brainsmoke/mechpad/README.md

# mechanical keypad

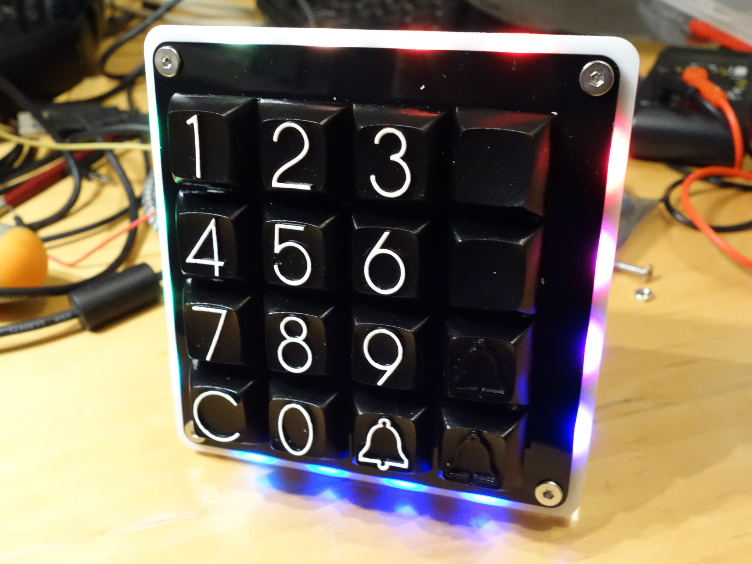
[picture p1: images/mechpad0.jpg]
|  |
|-|
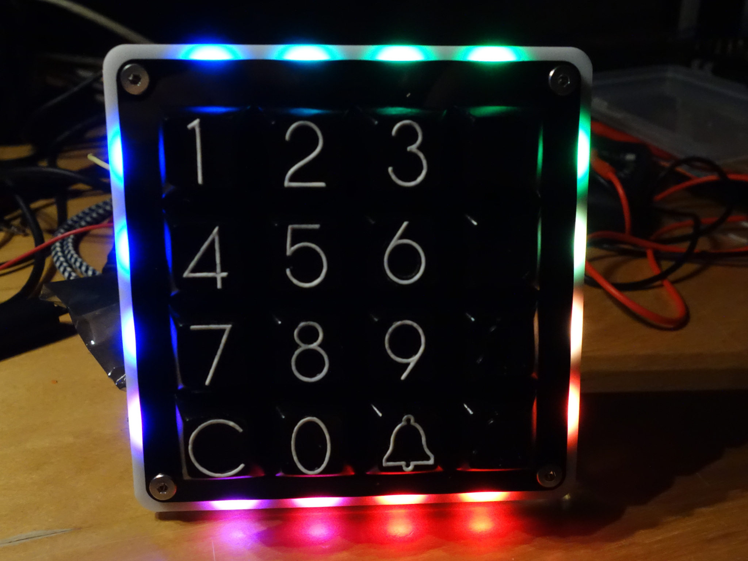
[picture p2: images/mechpad1.jpg]
|  |
