brainsmoke/mechpad/firmware/usbhid/README.md

# USB HID Keypad example

```
make -C ../libopencm3/ # if not done already
make
gdb-multiarch uartkeys.elf
set mem inaccessible-by-default off
target extended-remote /dev/ttyACM0
monitor swdp_scan
attach 1
load
run
```
