brainsmoke/mechpad/pcb/back.png

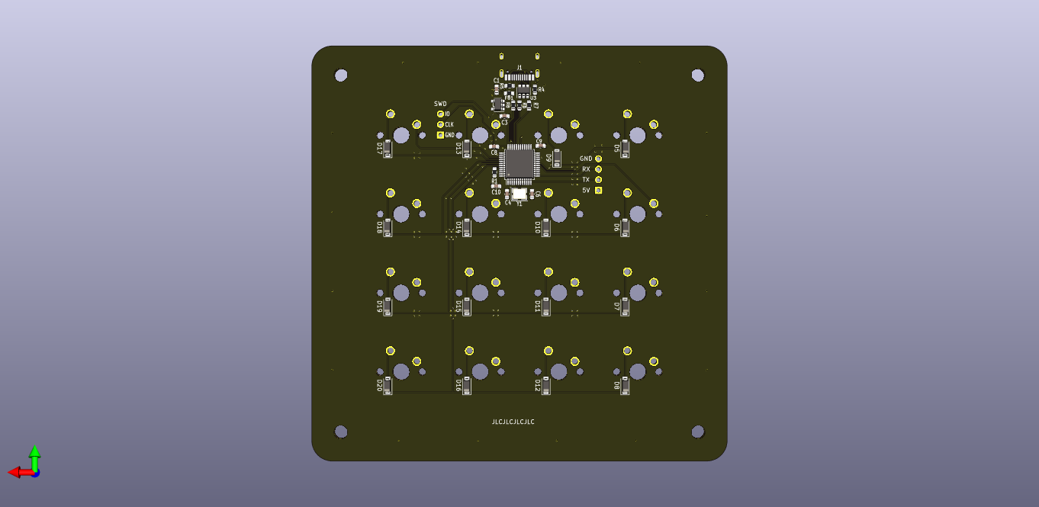
pcb/back.png
