brainsmoke/mechpad/pcb/pcb-bom.csv

Comment | Designator | Footprint | LCSC Part Number
100nF | C2 C5 C7 C11 C12 C13 C14 C15 C16 C17 C18 C19 C20 C21 C22 C23 | "0603" | "C14663"
SK6812SIDE-A-RVS | D1 D2 D3 D4 D21 D22 D23 D24 D25 D26 D27 D28 D29 D30 D31 D32 | SMD,2x4mm | C2890037
