brainsmoke/mechpad/keycaps/stl/7_fdm.stl

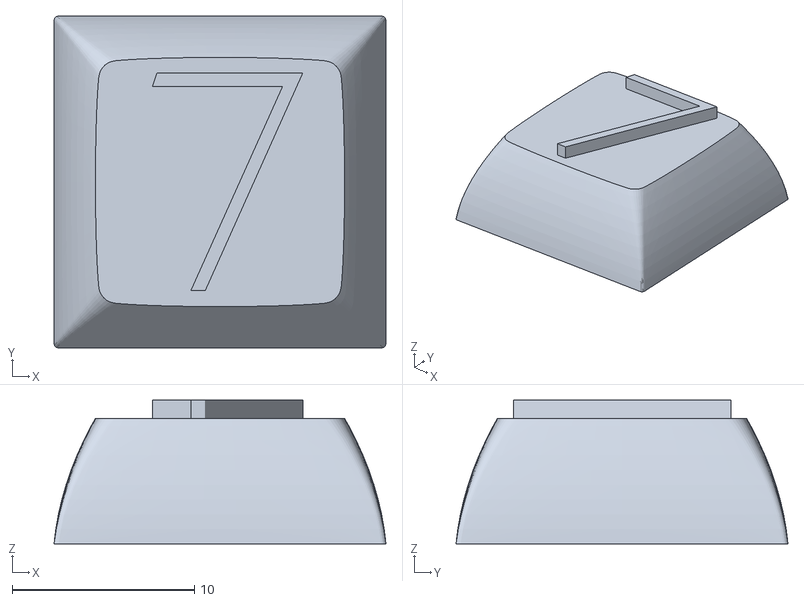
[picture p4: CAD file, 2024-06-29]
keycaps/stl/7_fdm.stl
18.2 x 18.2 x 7.90
