brainsmoke/mechpad/keycaps/stl/9_fdm.stl

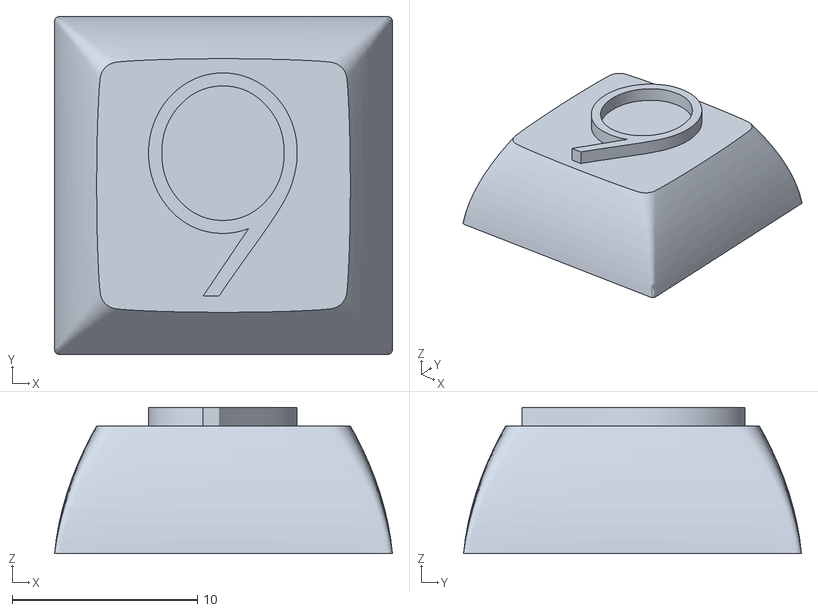
[picture p5: CAD file, 2024-06-29]
keycaps/stl/9_fdm.stl
18.2 x 18.2 x 7.90
