brainsmoke/mechpad/keycaps/stl/__fdm.stl

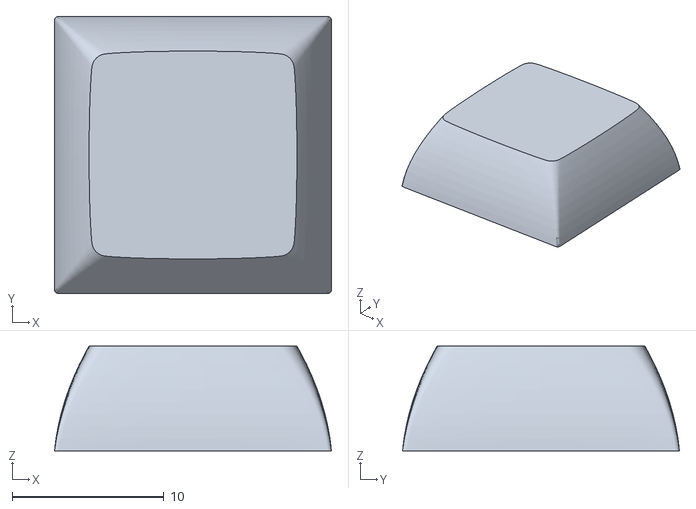
[picture p6: CAD file, 2024-06-29]
keycaps/stl/__fdm.stl
18.2 x 18.2 x 6.90
