brainsmoke/mechpad/keycaps/stl/6_sla.stl

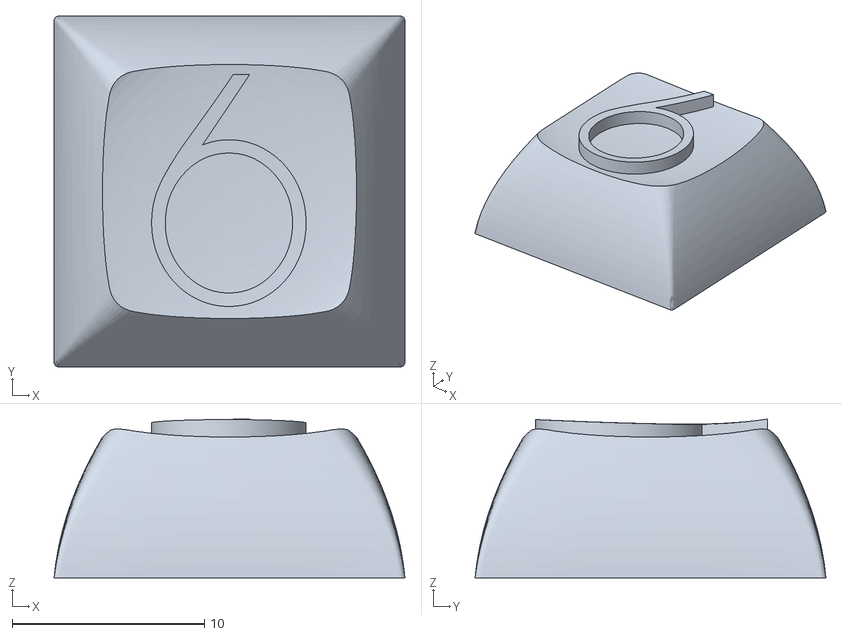
[picture p7: CAD file, 2023-10-21]
keycaps/stl/6_sla.stl
18.2 x 18.2 x 8.26
