brainsmoke/mechpad/keycaps/stl/1_sla.stl

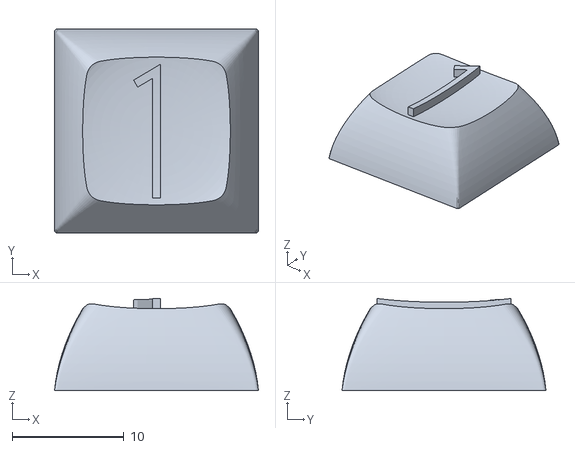
[picture p8: CAD file, 2023-10-21]
keycaps/stl/1_sla.stl
18.2 x 18.2 x 8.24
