brainsmoke/mechpad/keycaps/stl/5_sla.stl

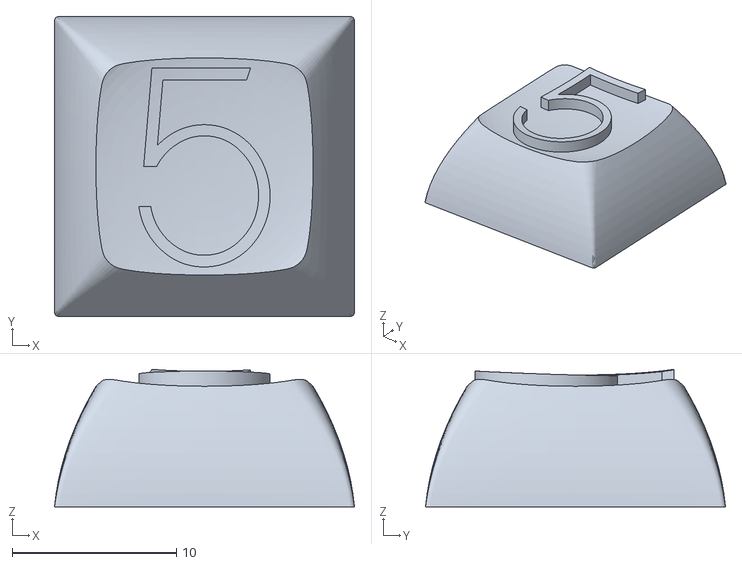
[picture p9: CAD file, 2023-10-21]
keycaps/stl/5_sla.stl
18.2 x 18.2 x 8.36
