brainsmoke/mechpad/keycaps/stl/8_sla.stl

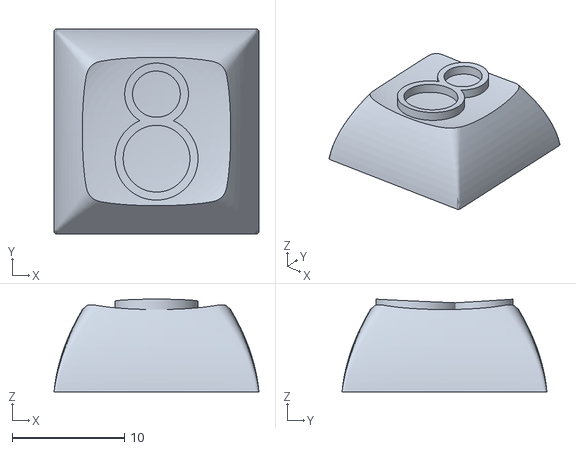
[picture p10: CAD file, 2023-10-21]
keycaps/stl/8_sla.stl
18.2 x 18.2 x 8.25
