brainsmoke/mechpad/keycaps/stl/7_sla.stl

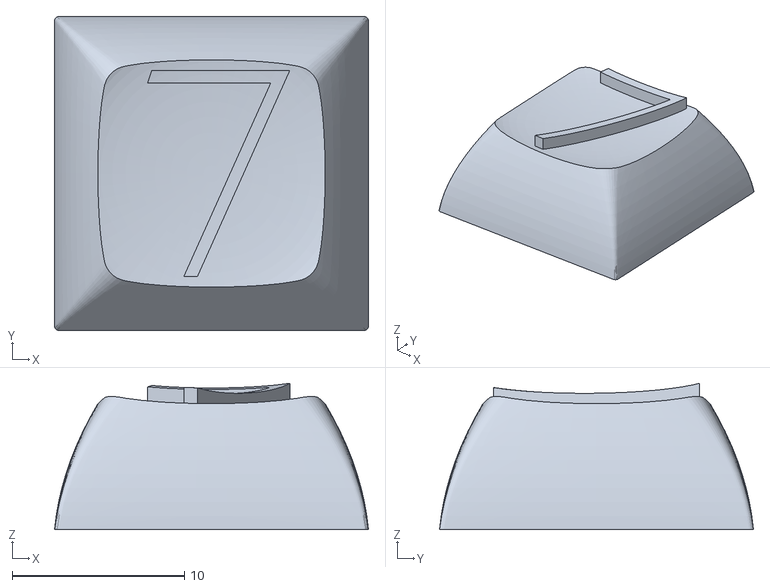
[picture p11: CAD file, 2023-10-21]
keycaps/stl/7_sla.stl
18.2 x 18.2 x 8.51
