brainsmoke/mechpad/keycaps/stl/2_sla.stl

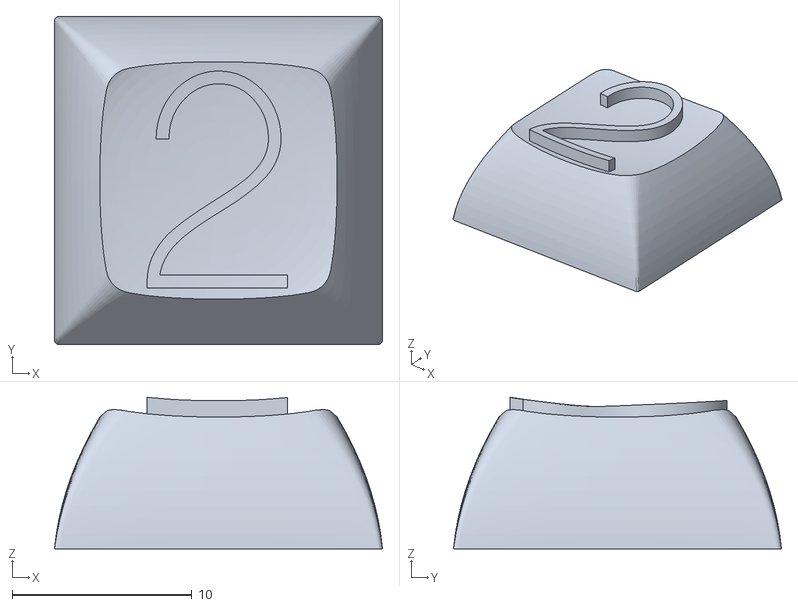
[picture p12: CAD file, 2023-10-21]
keycaps/stl/2_sla.stl
18.2 x 18.2 x 8.43
