brainsmoke/mechpad/keycaps/stl/__sla.stl

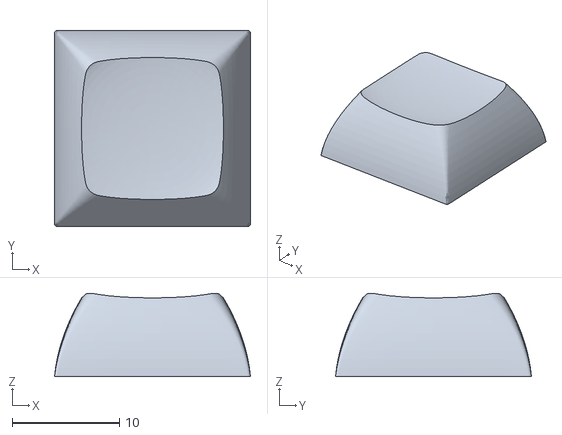
[picture p13: CAD file, 2023-10-21]
keycaps/stl/__sla.stl
18.2 x 18.2 x 7.74
