brainsmoke/mechpad/(list of files, cad)

Other CAD files:
keycaps/stl/8_fdm.stl
keycaps/stl/c_fdm.stl
keycaps/stl/b_fdm.stl
keycaps/stl/0_fdm.stl
keycaps/stl/5_fdm.stl
keycaps/stl/3_fdm.stl
keycaps/stl/2_fdm.stl
keycaps/stl/6_fdm.stl
keycaps/stl/1_fdm.stl
keycaps/stl/4_fdm.stl
keycaps/stl/c_sla.stl
keycaps/stl/9_sla.stl
keycaps/stl/3_sla.stl
keycaps/stl/4_sla.stl
keycaps/stl/b_sla.stl
keycaps/stl/0_sla.stl
keycaps/sla_keys.scad
