brainsmoke/mechpad/pcb/pcb.kicad_pcb

## KiCad design pcb/pcb.kicad_pcb (2023-12-17)

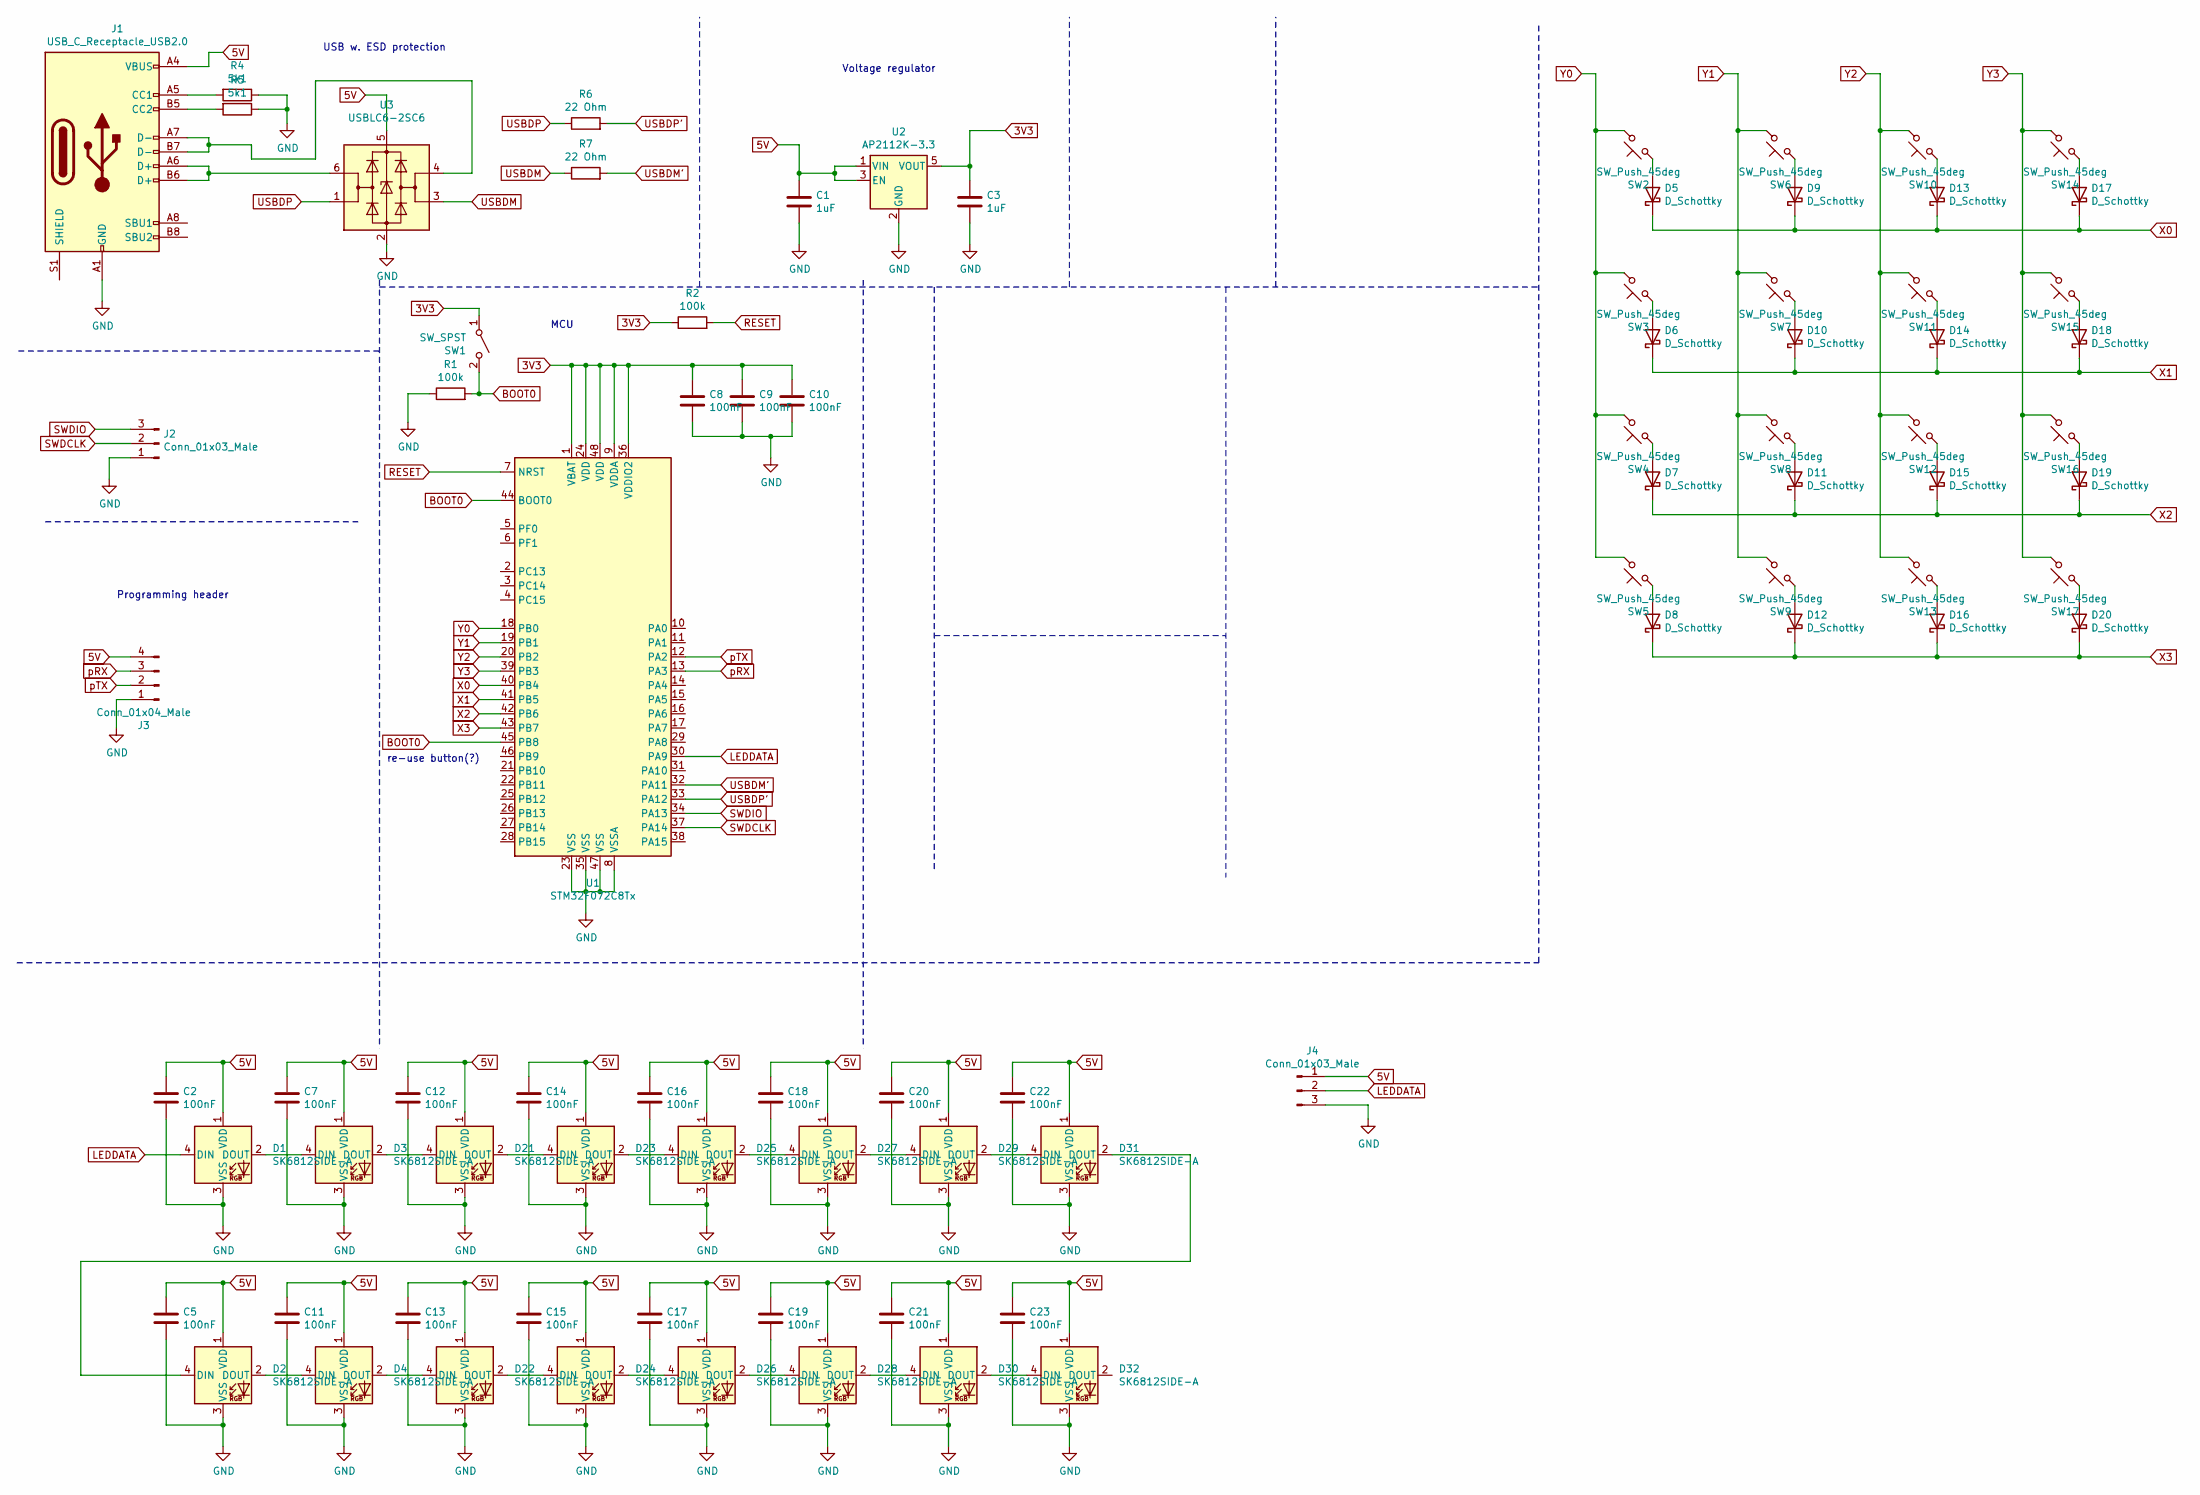
[picture p14: schematic pcb.sch]

Parts:
C1, C3: 1uF; C_0603_1608Metric
C2, C5, C7, C8, C9, C10, C11, C12, C13, C14, C15, C16, C17, C18, C19, C20, C21, C22, C23: 100nF; C_0603_1608Metric; LCSC C14663
D1, D2, D3, D4, D21, D22, D23, D24, D25, D26, D27, D28, D29, D30, D31, D32: SK6812SIDE-A; LED_SK6812SIDE-A_4020_pinlayout_asif50505-padssecure; LCSC C2890037
D5, D6, D7, D8, D9, D10, D11, D12, D13, D14, D15, D16, D17, D18, D19, D20: D_Schottky; D_SOD-123
J1: USB_C_Receptacle_USB2.0; USB_C_Receptacle_HRO_TYPE-C-31-M-12
J2, J4: Conn_01x03_Male; PinHeader_1x03_P2.54mm_Vertical
J3: Conn_01x04_Male; PinHeader_1x04_P2.54mm_Vertical
R1, R2: 100k; R_0603_1608Metric
R4, R5: 5k1; R_0603_1608Metric
R6, R7: 22 Ohm; R_0603_1608Metric
SW1: SW_SPST; SW_Push_1P1T_NO_CK_KMR2
SW2, SW3, SW4, SW5, SW6, SW7, SW8, SW9, SW10, SW11, SW12, SW13, SW14, SW15, SW16, SW17: SW_Push_45deg; SW_Cherry_MX_1.00u_PCB
U1: STM32F072C8Tx; LQFP-48_7x7mm_P0.5mm
U2: AP2112K-3.3; SOT-23-5
U3: USBLC6-2SC6; SOT-23-6

Connections:
3V3: C3.1, C8.1, C9.1, C10.1, R2.1, SW1.1 (A), U1.1 (VBAT), U1.9 (VDDA), U1.24 (VDD), U1.36 (VDDIO2), U1.48 (VDD), U2.5 (VOUT)
5V: C1.1, C2.1, C5.1, C7.1, C11.1, C12.1, C13.1, C14.1, C15.1, C16.1, C17.1, C18.1, C19.1, C20.1, C21.1, C22.1, C23.1, D1.1 (VDD), D2.1 (VDD), D3.1 (VDD), D4.1 (VDD), D21.1 (VDD), D22.1 (VDD), D23.1 (VDD), D24.1 (VDD), D25.1 (VDD), D26.1 (VDD), D27.1 (VDD), D28.1 (VDD), D29.1 (VDD), D30.1 (VDD), D31.1 (VDD), D32.1 (VDD), J1.A4 (VBUS), J1.A9 (VBUS), J1.B4 (VBUS), J1.B9 (VBUS), J3.4, J4.1, U2.1 (VIN), U2.3 (EN), U3.5 (VBUS)
BOOT0: R1.2, SW1.2 (B), U1.44 (BOOT0), U1.45 (PB8)
GND: C1.2, C2.2, C3.2, C5.2, C7.2, C8.2, C9.2, C10.2, C11.2, C12.2, C13.2, C14.2, C15.2, C16.2, C17.2, C18.2, C19.2, C20.2, C21.2, C22.2, C23.2, D1.3 (VSS), D2.3 (VSS), D3.3 (VSS), D4.3 (VSS), D21.3 (VSS), D22.3 (VSS), D23.3 (VSS), D24.3 (VSS), D25.3 (VSS), D26.3 (VSS), D27.3 (VSS), D28.3 (VSS), D29.3 (VSS), D30.3 (VSS), D31.3 (VSS), D32.3 (VSS), J1.A1 (GND), J1.A12 (GND), J1.B1 (GND), J1.B12 (GND), J2.1, J3.1, J4.3, R1.1, R4.1, R5.1, U1.8 (VSSA), U1.23 (VSS), U1.35 (VSS), U1.47 (VSS), U2.2 (GND), U3.2 (GND)
LEDDATA: D1.4 (DIN), J4.2, U1.30 (PA9)
unnamed: D1.2 (DOUT), D3.4 (DIN)
unnamed: D2.2 (DOUT), D4.4 (DIN)
unnamed: D2.4 (DIN), D31.2 (DOUT)
unnamed: D5.2 (A), SW2.1
unnamed: D6.2 (A), SW3.1
unnamed: D7.2 (A), SW4.1
unnamed: D8.2 (A), SW5.1
unnamed: D9.2 (A), SW6.1
unnamed: D10.2 (A), SW7.1
unnamed: D11.2 (A), SW8.1
unnamed: D12.2 (A), SW9.1
unnamed: D13.2 (A), SW10.1
unnamed: D14.2 (A), SW11.1
unnamed: D15.2 (A), SW12.1
unnamed: D16.2 (A), SW13.1
unnamed: D17.2 (A), SW14.1
unnamed: D18.2 (A), SW15.1
unnamed: D19.2 (A), SW16.1
unnamed: D20.2 (A), SW17.1
unnamed: D21.2 (DOUT), D23.4 (DIN)
unnamed: D3.2 (DOUT), D21.4 (DIN)
unnamed: D22.2 (DOUT), D24.4 (DIN)
unnamed: D4.2 (DOUT), D22.4 (DIN)
unnamed: D23.2 (DOUT), D25.4 (DIN)
unnamed: D24.2 (DOUT), D26.4 (DIN)
unnamed: D25.2 (DOUT), D27.4 (DIN)
unnamed: D26.2 (DOUT), D28.4 (DIN)
unnamed: D27.2 (DOUT), D29.4 (DIN)
unnamed: D28.2 (DOUT), D30.4 (DIN)
unnamed: D29.2 (DOUT), D31.4 (DIN)
unnamed: D30.2 (DOUT), D32.4 (DIN)
unnamed: J1.A5 (CC1), R4.2
unnamed: J1.A6 (D+), J1.B6 (D+), U3.6 (I/O1)
unnamed: J1.A7 (D-), J1.B7 (D-), U3.4 (I/O2)
unnamed: J1.B5 (CC2), R5.2
RESET: R2.2, U1.7 (NRST)
SWDCLK: J2.2, U1.37 (PA14)
SWDIO: J2.3, U1.34 (PA13)
USBDM: R7.1, U3.3 (I/O2)
USBDM': R7.2, U1.32 (PA11)
USBDP: R6.1, U3.1 (I/O1)
USBDP': R6.2, U1.33 (PA12)
X0: D5.1 (K), D9.1 (K), D13.1 (K), D17.1 (K), U1.40 (PB4)
X1: D6.1 (K), D10.1 (K), D14.1 (K), D18.1 (K), U1.41 (PB5)
X2: D7.1 (K), D11.1 (K), D15.1 (K), D19.1 (K), U1.42 (PB6)
X3: D8.1 (K), D12.1 (K), D16.1 (K), D20.1 (K), U1.43 (PB7)
Y0: SW2.2, SW3.2, SW4.2, SW5.2, U1.18 (PB0)
Y1: SW6.2, SW7.2, SW8.2, SW9.2, U1.19 (PB1)
Y2: SW10.2, SW11.2, SW12.2, SW13.2, U1.20 (PB2)
Y3: SW14.2, SW15.2, SW16.2, SW17.2, U1.39 (PB3)
pRX: J3.3, U1.13 (PA3)
pTX: J3.2, U1.12 (PA2)

Notes on the sheet:
Programming header
USB w. ESD protection
Voltage regulator
MCU
re-use button(?)

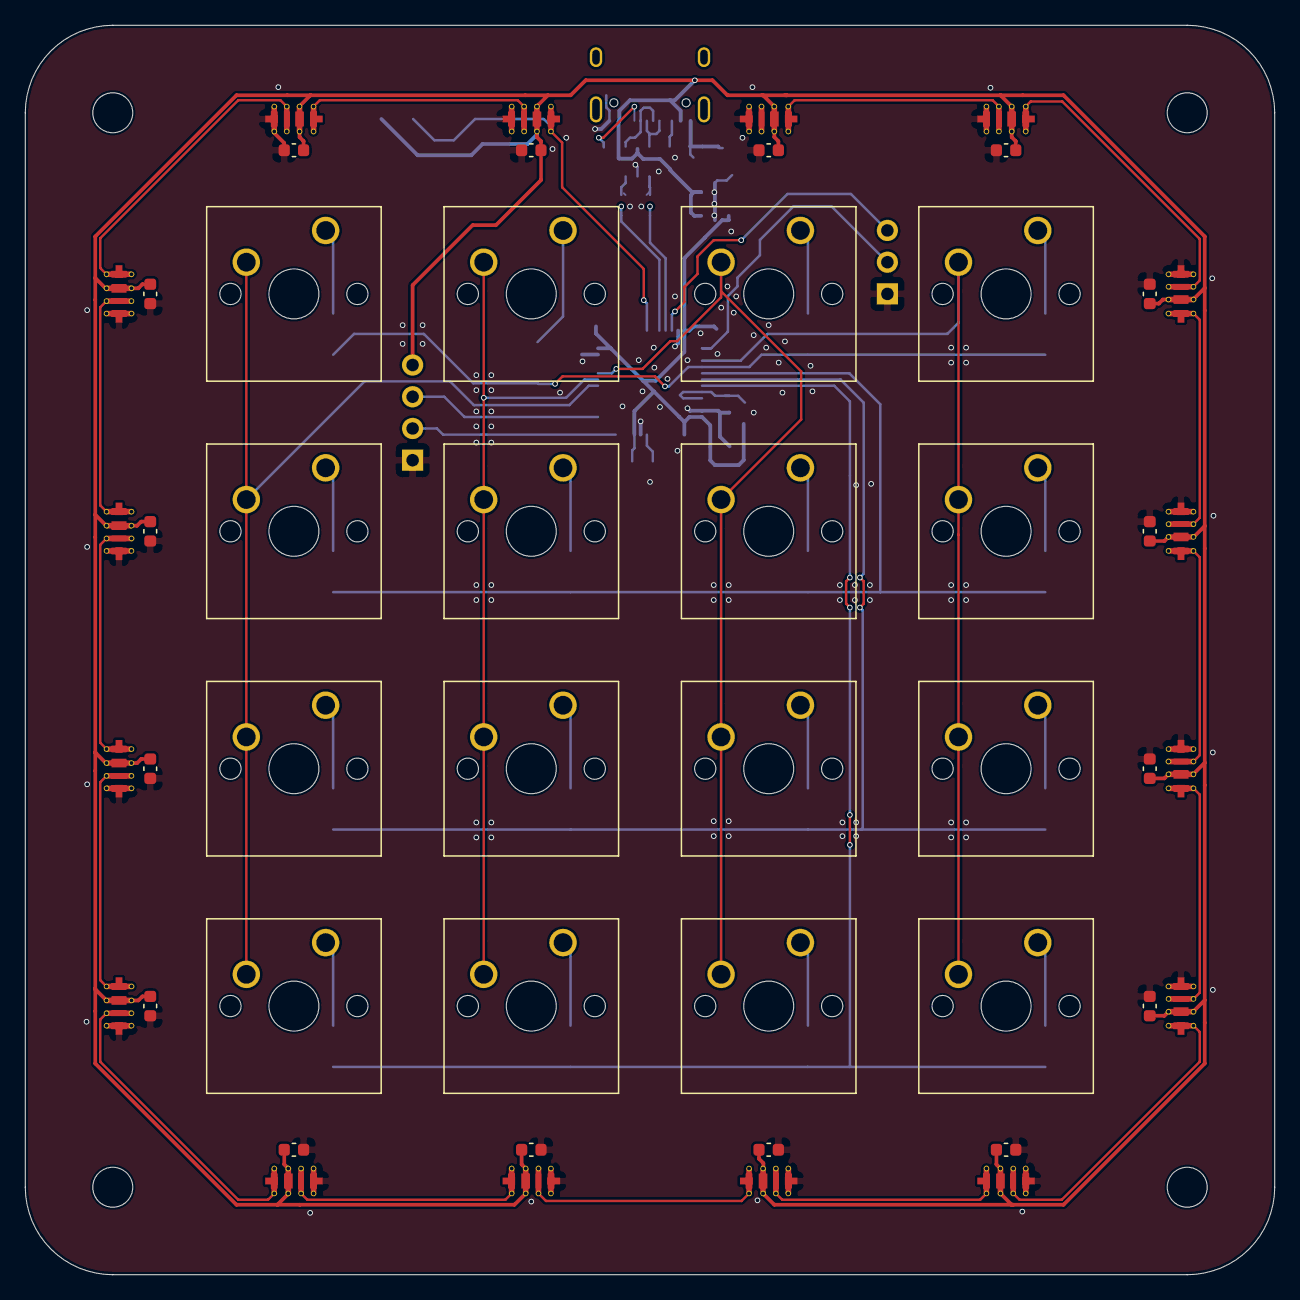
[picture p15: board pcb.kicad_pcb from above]

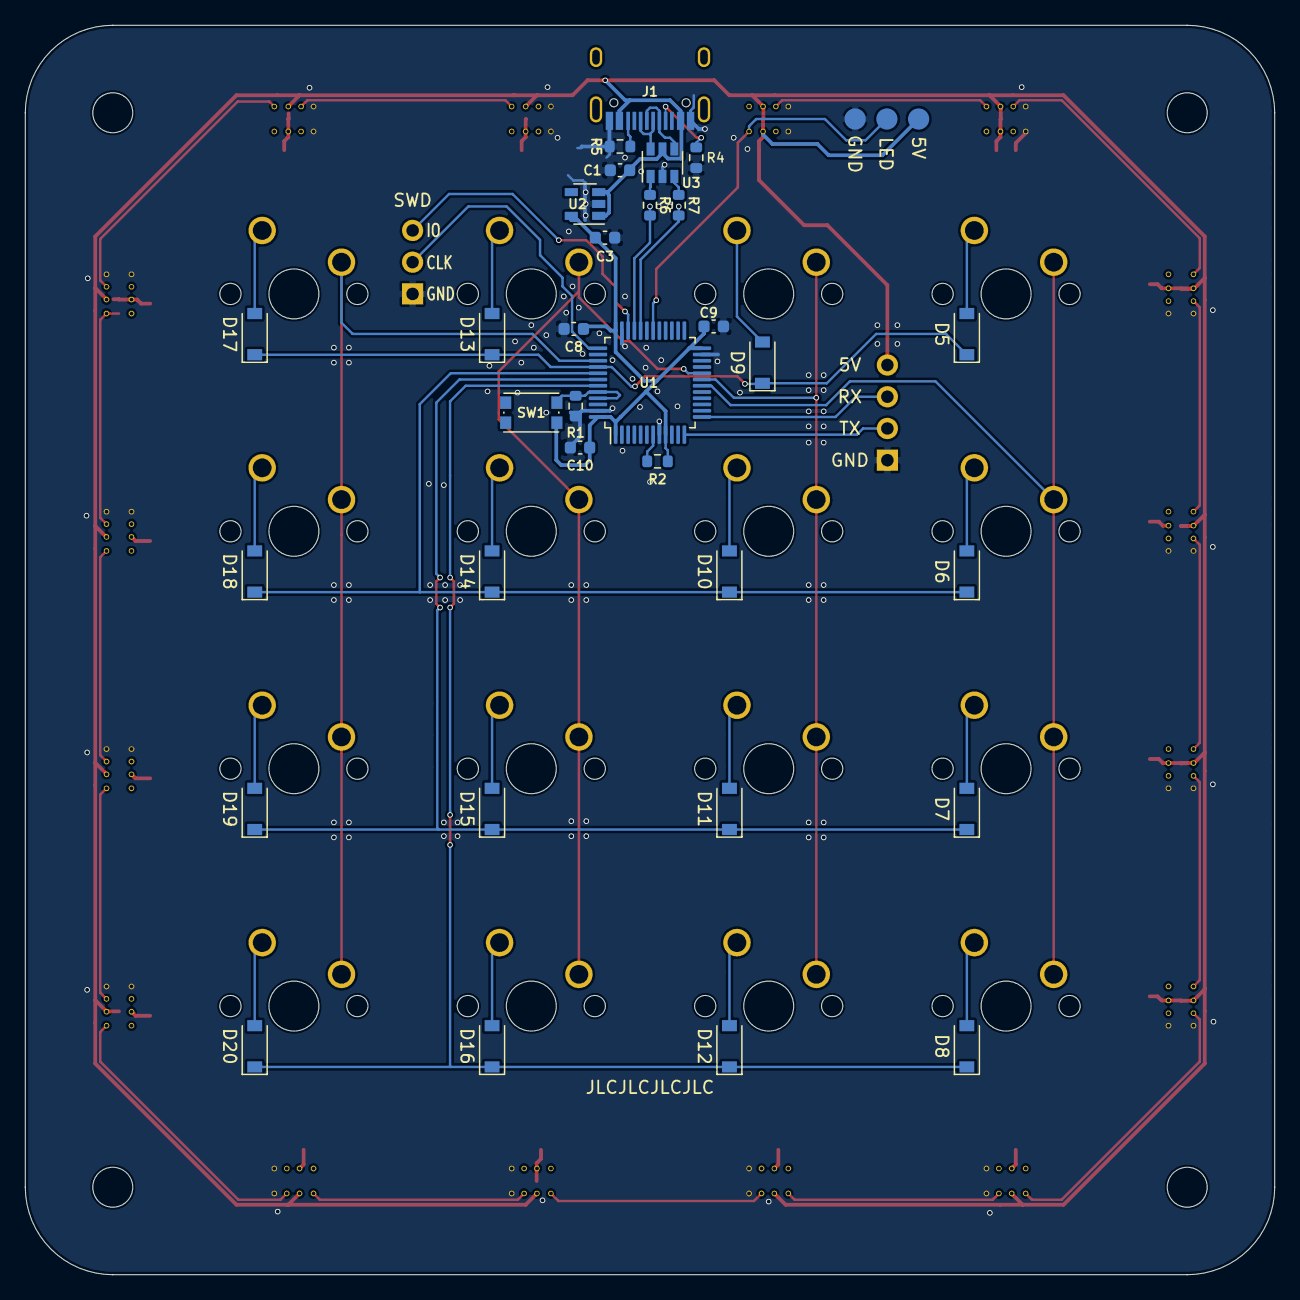
[picture p16: board pcb.kicad_pcb from below]

Board: 2 copper layers, 100.0 x 100.0 mm, 83 parts (34 on the bottom side), 57 nets.
