brainsmoke/mechpad/(commit log)

2023-10-17 init commit
    [pcb.kicad_pcb, pcb.sch]
2023-10-17 change headers
    [pcb.kicad_pcb, pcb.sch]
2023-10-17 add gerbers
    [pcb-B_Cu.gbl, pcb-B_Mask.gbs, pcb-B_SilkS.gbo, pcb-Edge_Cuts.gm1, pcb-F_Cu.gtl, pcb-F_Mask.gts, pcb-F_SilkS.gto, pcb-job.gbrjob]
2023-10-17 move pcb to subdir
    [pcb-B_Cu.gbl, pcb-B_Mask.gbs, pcb-B_SilkS.gbo, pcb-Edge_Cuts.gm1, pcb-F_Cu.gtl, pcb-F_Mask.gts, pcb-F_SilkS.gto, pcb-job.gbrjob]
2023-10-20 add keycap files
    [flat_keys.scad]
2023-10-21 rename dir
    [flat_keys.scad]
2023-10-21 clean up construction in flat_keys.scad
    [flat_keys.scad]
2023-10-21 add stl files
    [g0.stl, g1.stl, g2.stl, g3.stl, g4.stl, g5.stl, g6.stl, g7.stl]
2023-11-01 correct silkscreen labels (oops)
    [pcb.kicad_pcb]
2023-11-02 make leds work
2023-11-03 move led code to common dir
2023-11-03 add some more led animations
2023-11-03 add boot0 button
    [pcb.kicad_pcb, pcb.sch]
2023-11-03 remove osc.
    [pcb-B_Cu.gbl, pcb-B_Mask.gbs, pcb-B_SilkS.gbo, pcb-Edge_Cuts.gm1, pcb-F_Cu.gtl, pcb-F_Mask.gts, pcb-F_SilkS.gto, pcb-job.gbrjob]
2023-11-04 stm32f103 -> stm32f072
    [pcb.kicad_pcb, pcb.sch]
2023-11-11 make leds brighter
2023-11-12 add case
2023-11-19 remove ferrite
    [pcb.kicad_pcb, pcb.sch]
2023-11-19 add led probe pads
    [pcb.kicad_pcb, pcb.sch]
2023-11-21 make solder pads more solid in case of desoldering
    [pcb.kicad_pcb]
2023-11-22 optimize tracks
    [pcb.kicad_pcb]
2023-11-27 ws2812b-4020 -> sk6812-side-a
    [pcb-bom.csv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]
2023-11-28 increase clearance
    [pcb.kicad_pcb]
2023-11-28 add comment with possible tweaks
    [flat_keys.scad]
2023-12-15 add case for v2
2023-12-15 add gerbers for v2
2023-12-17 remove unecessary pull-up on USB-DP
    [pcb.kicad_pcb, pcb.sch]
2024-04-10 case for v2 improvements
2024-06-29 add key STLs optimised for fdm
    [fdm_keys.scad, g0_fdm.stl, g1_fdm.stl, g2_fdm.stl, g3_fdm.stl, g4_fdm.stl, g5_fdm.stl, g6_fdm.stl]
2024-07-05 use Makefile for keys
    [0_fdm.stl, 0_sla.stl, 1_fdm.stl, 1_sla.stl, 2_fdm.stl, 2_sla.stl, 3_fdm.stl, 3_sla.stl]
2024-07-26 add pcb cache
